Maratagliullin/ARDUINO/skarsta/models/hall-encoder/hall-mount.stl

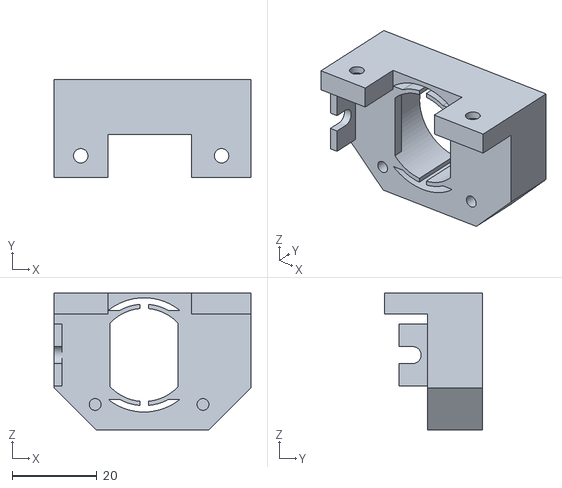
[picture p1: CAD file, 2020-01-19]
skarsta/models/hall-encoder/hall-mount.stl
46.6 x 23.1 x 32.3
