Maratagliullin/ARDUINO/skarsta/models/hall-encoder/hall-adapter.stl

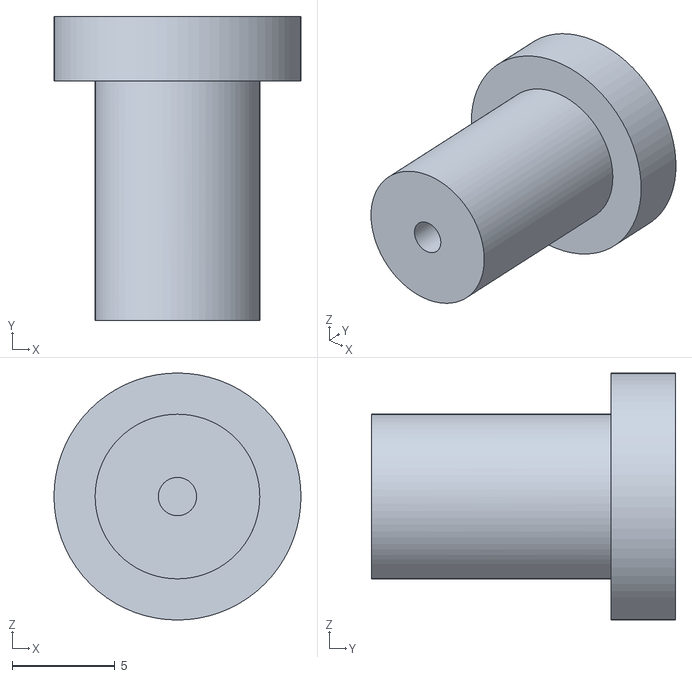
[picture p2: CAD file, 2020-01-19]
skarsta/models/hall-encoder/hall-adapter.stl
12.0 x 14.8 x 12.0
