Maratagliullin/ARDUINO/skarsta/models/hall-encoder/hall-cover.stl

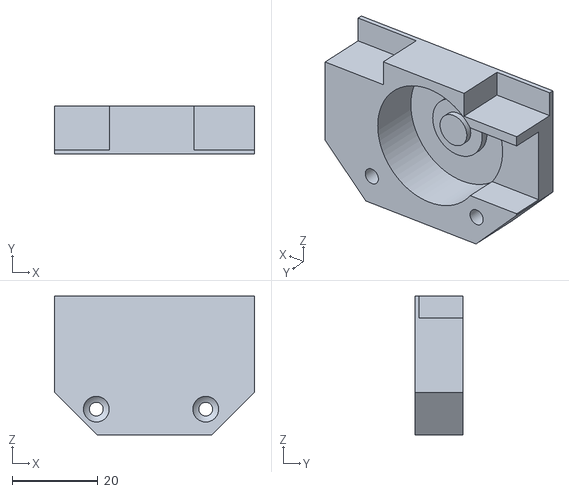
[picture p3: CAD file, 2020-01-19]
skarsta/models/hall-encoder/hall-cover.stl
46.6 x 11.3 x 32.3
